HuyHuy-bit/vericore-verified-rv32i-fpga-soc/docs/media/portfolio-demo.txt

LIVE VERIFICATION
$ python3 tools/verification.py run --profile fast
fast correctness: PASS
$ make --no-print-directory lockstep-sample
Spike lockstep sample: PASS

RV32I PIPELINE — VERIFIED PORTFOLIO SNAPSHOT

tooling 21df7609ef9d | RTL d21ecd3fe310
Ubuntu 24.04 | Verilator 5.048 | RISC-V GCC 13.2.0-2024.04.12 | binutils 2.42 | Python 3.12

CORRECTNESS
decoder 2,120/2,120 | hazards 262,144/262,144 | harness 109/109
directed 150/150 | predictors 75/75 | coverage 44/44

REFERENCE FLOWS
architecture signatures 38/38
complete Spike traces 38/38
random Spike programs 200/200

BENCHMARKS — cycles / CPI
| Kernel | 10-cycle uncached | +1KB 4-way I$ | +4KB 4-way WB D$ | 1-cycle uncached |
|---|---:|---:|---:|---:|
| crc32 | 758,160 / 10.28041 | 151,765 / 2.05789 | 152,021 / 2.06136 | 75,816 / 1.02804 |
| matmul | 3,504,148 / 11.37629 | 710,907 / 2.30797 | 711,691 / 2.31052 | 361,402 / 1.17330 |
| sort | 2,227,300 / 11.02875 | 471,714 / 2.33575 | 504,610 / 2.49864 | 252,106 / 1.24833 |
| llist | 932,270 / 10.00236 | 186,587 / 2.00190 | 187,611 / 2.01289 | 93,227 / 1.00024 |
| interp | 14,652,250 / 11.69906 | 2,932,916 / 2.34178 | 2,933,124 / 2.34195 | 1,467,250 / 1.17152 |

ROUTED ARTIX-7 RESULTS
| Configuration | LUT | FF | BRAM tiles | WNS (ns) | Critical path (ns) | fmax (MHz) |
|---|---:|---:|---:|---:|---:|---:|
| Core | 4,031 | 5,220 | 0.5 | -11.111 | 13.111 | 76.272 |
| +1KB 4-way I$ | 5,011 | 6,970 | 2.0 | -11.563 | 13.563 | 73.730 |
| +4KB 4-way WT D$ | 8,800 | 13,527 | 4.0 | -12.172 | 14.172 | 70.562 |
| +4KB 4-way WB D$ | 9,218 | 13,517 | 4.0 | -11.920 | 13.920 | 71.839 |

REPRODUCE
make verify
make synth-matrix && make synth-summary
make portfolio-gif

All displayed values passed schema, provenance, population, arithmetic, and hash checks.
