HuyHuy-bit/vericore-verified-rv32i-fpga-soc/results/benchmarks.csv

schema | tooling_commit | rtl_commit | configuration | imem_latency | dmem_latency | icache_bytes | icache_block_words | icache_ways | dcache_bytes | dcache_block_words | dcache_ways | dcache_policy | btb_index_bits | btb_tag_bits | gshare | ras_depth | kernel | status | cycles | instructions_retired | memory_stall_cycles | branches | mispredictions | icache_accesses | icache_misses | dcache_accesses | dcache_misses
1 | 21df7609ef9dc746ded58762ac2d03471a291eb5 | d21ecd3fe310bf49c505220c134f8cfd205c90e5 | icache | 10 | 10 | 1024 | 4 | 4 | 0 | 4 | 1 | none | 6 | 10 | 0 | 8 | crc32 | pass | 151765 | 73748 | 75949 | 10756 | 1033 | 75816 | 13 | 0 | 0
1 | 21df7609ef9dc746ded58762ac2d03471a291eb5 | d21ecd3fe310bf49c505220c134f8cfd205c90e5 | icache | 10 | 10 | 1024 | 4 | 4 | 0 | 4 | 1 | none | 6 | 10 | 0 | 8 | matmul | pass | 710907 | 308022 | 349505 | 109364 | 26689 | 361402 | 31 | 0 | 0
1 | 21df7609ef9dc746ded58762ac2d03471a291eb5 | d21ecd3fe310bf49c505220c134f8cfd205c90e5 | icache | 10 | 10 | 1024 | 4 | 4 | 0 | 4 | 1 | none | 6 | 10 | 0 | 8 | sort | pass | 471714 | 201954 | 219608 | 66563 | 8755 | 252106 | 14 | 0 | 0
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
