HuyHuy-bit/vericore-verified-rv32i-fpga-soc/rtl/memory/data_mem.sv

// data_mem.sv - word-addressed data memory with per-lane write enables.
//
// Deals only in whole words plus byte enables; lsu.sv turns RISC-V load/store
// semantics into that. LATENCY is modelled by mem_timing, as for instr_mem.
`default_nettype none

import rv32i_pkg::*;

module data_mem #(
    parameter int LATENCY     = 1,
    parameter int DEPTH_WORDS = 16384
) (
    input  var logic        clk,
    input  var logic        rst,
    input  var logic        req,          // this cycle genuinely presents an access
    input  var logic        burst,        // requester is walking sequential words
    input  var logic [XLEN-1:0] addr,         // byte address
    input  var logic [XBYTES-1:0] byte_en,      // lanes to write (0 = this is a read)
    input  var logic [XLEN-1:0] write_word,   // already shifted into its lane
    output var logic [XLEN-1:0] read_word,
    output var logic        ready
);
    localparam int WORDW = $clog2(DEPTH_WORDS);

    // Word-addressed array; subword access handled via per-byte write strobes.
    logic [XLEN-1:0] mem_array [0:DEPTH_WORDS-1];

`ifndef SYNTHESIS
    string data_file;
    initial begin
        if ($value$plusargs("DATAFILE=%s", data_file)) begin
            $readmemh(data_file, mem_array);
        end
    end
`else
    // See the matching comment in instr_mem.sv: content is irrelevant for
    // resource/timing analysis, this just gives synthesis a BRAM to infer.
    initial $readmemh("blank_data.hex", mem_array);
`endif

    // Only the low bits are decoded; bits above them are deliberately
    // ignored, not validated. The linker script places RAM at 0x00300000
    // specifically so this aliases back into word 0 upward — see
    // compliance/link/rv32i-pipeline.ld's header comment. An "address in
    // range" assertion here would be checking the RTL against a premise the
    // rest of the system doesn't hold.
    logic [WORDW-1:0] word_idx;
    assign word_idx = addr[WORDW+1:2];

    mem_timing #(.LATENCY(LATENCY)) u_timing (
        .clk(clk), .rst(rst),
        .req(req), .burst(burst), .addr(addr), .ready(ready)
    );

    // A store commits only on the cycle its access completes, not on every
    // cycle it sits in MEM waiting for the memory to answer.
    logic [XBYTES-1:0] we;
    assign we = byte_en & {XBYTES{ready}};

    // Looped rather than four unrolled lanes: the lane count is XBYTES, and
    // writing it out by hand is what pins a memory to one data width.
    always_ff @(posedge clk) begin
        for (int b = 0; b < XBYTES; b++) begin
            if (we[b]) mem_array[word_idx][8*b +: 8] <= write_word[8*b +: 8];
        end
    end

    assign read_word = mem_array[word_idx];
endmodule

`default_nettype wire
