HuyHuy-bit/vericore-verified-rv32i-fpga-soc/(commit log)

2026-08-05 Run random Spike lockstep in CI and pin Spike to a fixed commit
2026-08-05 Re-measure all four synthesis configs against the current RTL
2026-08-24 Make harness fixtures self-contained
    [test_harness.py]
2026-08-24 Reject invalid lockstep statuses and trace fields
2026-08-24 Propagate coverage and soak input failures
    [test_harness.py]
2026-08-24 Order load-hazard checks after stall assignment
    [hazard_detect.sv]
2026-08-26 Pin external verification contracts
2026-08-26 Fix D-cache performance accounting
    [backend.sv, cpu_tb.cpp, dcache.sv, dcache_counter_tb.sv, test_harness.py]
2026-08-27 Pin the verification environment
2026-08-27 Pin the exact assembler version
2026-08-28 Fix containerized demo recording
    [test_portfolio_demo.py, test_tool_environment.py]
2026-08-28 Publish current verification evidence
    [benchmarks.csv, synthesis.csv]
2026-08-29 evidence: refresh measured verification and implementation results
    [benchmarks.csv, synthesis.csv]
2026-08-29 docs: define board-ready Wishbone SoC
2026-08-29 docs: plan board-ready SoC implementation
2026-08-29 fix: make portfolio evidence trustworthy
    [evidence_check.py, portfolio_demo.py, render_portfolio.py, results.py, test_evidence_check.py, test_portfolio_demo.py, test_render_portfolio.py, test_results.py]
2026-08-30 feat: expose core memory and external interrupts
2026-08-30 feat: add UART and GPIO board control
2026-08-31 feat: verify firmware and add Arty A7 flow
2026-08-31 ci: validate and document the board-ready SoC
2026-08-31 build: validate board timing constraints exactly
2026-08-31 build: harden disconnected board programming
2026-09-01 verification: add routed board timing simulation
2026-09-01 docs: rename board-ready SoC design
2026-09-20 track syns provenance out from func result
2026-09-20 fix portfolio demo, evidence
    [benchmarks.csv]
