HuyHuy-bit/vericore-verified-rv32i-fpga-soc/(notices)

Notices in the files:
README.md:
License: MIT
